pokeygithub/KLOR/(commit log)

2023-06-18 Pimoroni supported KLOR
    My first attempt to support pimoroni trackball with QMK.
    [klor1_3-B_Mask.gbs, klor1_3-B_Paste.gbp, klor1_3-B_Silkscreen.gbo, klor1_3-Edge_Cuts.gm1, klor1_3-F_Mask.gts, klor1_3-F_Paste.gtp, klor1_3-F_Silkscreen.gto, klor1_3-NPTH.drl]
2023-06-18 Updated Gerbers
    Got the JPs fixed to match wiring, that was a PITA.
    [klor1_3-B_Mask.gbs, klor1_3-B_Paste.gbp, klor1_3-B_Silkscreen.gbo, klor1_3-Edge_Cuts.gm1, klor1_3-F_Mask.gts, klor1_3-F_Paste.gtp, klor1_3-F_Silkscreen.gto, klor1_3-NPTH.drl]
